ThotAlion/vanille_board_firmware/vanille_board_firmware/dog.jpg

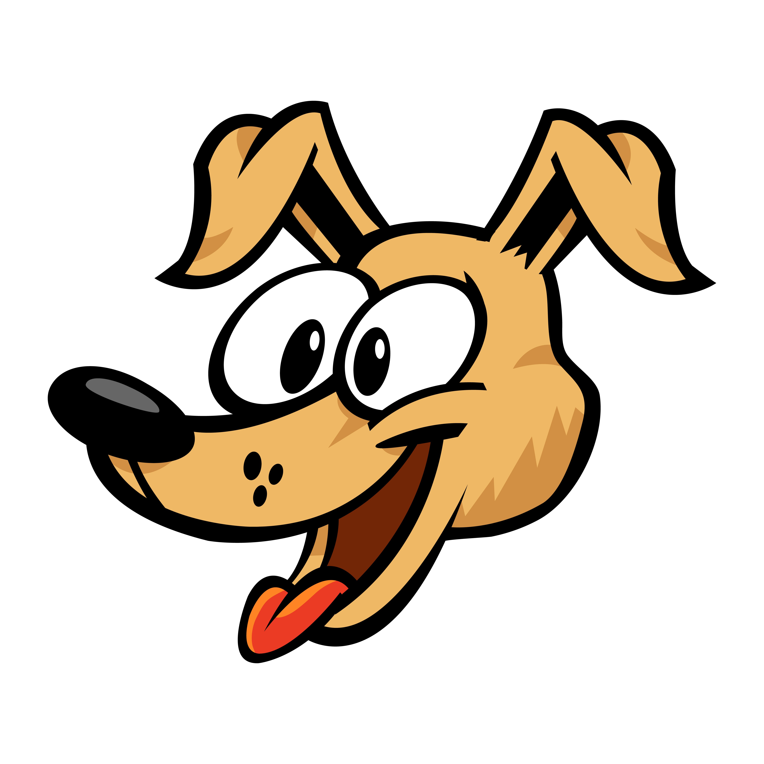
vanille_board_firmware/dog.jpg
