ThotAlion/vanille_board_firmware/vanille_board_firmware/dog.cpp

/***********************************************************************
************************************************************************
**                                                                    **
**       --------------Sparking Bitmap Converter--------------        **
**     Developed for I2C LCD, an easy-to-use display tool for makers. **
**                       Joney.S@foxmail.com                          **
**                                                                    **
************************************************************************
************************************************************************
*
* Code generated by
*
*        Sparking-BitmapConverter v1.0
*        Compiled May 15 2015
*        Sparking Work Speace
*
************************************************************************
*
* Source file: dog.jpg
* Dimensions:  56 * 48
*
************************************************************************
*/

#include "I2C_LCD.h"


#ifndef GUI_STORAGE_PTR
  #define GUI_STORAGE_PTR PROGMEM
#endif


const unsigned char GUI_STORAGE_PTR acdog[] = {
  ________, ________, ______X_, ________, ________, ________, ________,
  ________, ________, ___XXXXX, ________, ________, __XXX___, ________,
  ________, ______XX, XXXX___X, ________, ________, _X__XXXX, XX______,
  ________, _____XX_, _XX____X, ________, ________, _X___XXX, _XX_____,
  ________, _____X__, _X____X_, X_______, ________, XX____XX, __XX____,
  ________, ____XX__, X_______, X_______, ________, X_X____X, ___X____,
  ________, ____XX__, _____XX_, XX______, _______X, X_XX____, X__XX___,
  ________, ____XX__, _____XXX, _X______, _______X, __XX____, ___XX___,
  ________, ____XX__, ____XXXX, _XX_____, ______XX, _XXX____, ___XX___,
  ________, ____XX__, ___XXXXX, X_XX____, ______X_, XXXXX___, ___XX___,
  ________, ____XX__, ___XX_XX, XX_X____, _____X__, XXX_XX__, ___XX___,
  ________, ____X___, __X_XX_X, XXXXXXXX, XXXXXX_X, XXXXXX__, ___XX___,
  ________, ____X___, _XX__XX_, XXXX____, ______XX, XX_X__X_, ____X___,
  ________, ___XX___, XX____XX, XXX_____, ________, X_X____X, ____XX__,
  ________, __XX___X, X____XXX, XX______, ________, _XX____X, X____X__,
  ________, _XXXXXX_, __XX____, __XX_XXX, XXXX____, _XX_____, _XXXXXXX,
  ________, ________, _X______, ___XX___, ___X____, __X_____, ___XXX__,
  ________, ________, X_______, __X_____, ___XX___, __X_____, ________,
  ________, _______X, ________, __X_____, ____X___, __X_____, ________,
  ________, _______X, _____XX_, _X_X____, ____X___, __X_____, ________,
  ________, ______X_, ____XX__, X_XX____, ____X___, __X_____, ________,
  ________, ______X_, ____XXX_, X_X_X___, ___X____, __X_____, ________,
  ________, ______X_, ____XXX_, X_XXX___, ___X____, ___X____, ________,
  _XXXXXX_, _____XX_, ___XXX__, X_XX____, __X_____, ____X___, ________,
  XXXXXXXX, X_____X_, ____XXXX, X_XX____, XXXXX___, ____XX__, ________,
  XXXXXXXX, XX____XX, X___XXX_, XX___XXX, ________, _____X__, ________,
  XXXXXXXX, XXX____X, XXXXX___, _XXXX___, ________, _____X__, ________,
  _XXXXXXX, XXXXXXXX, XXX_____, ___X____, XXX_____, ____XX__, ________,
  __XXXXXX, XXXXX___, ________, _____XXX, XXX_____, ____XX__, ________,
  ___XXXXX, XXXX____, ________, ____XXXX, X_______, ____XX__, ________,
  ___XXXXX, XXX_____, XX______, _____XXX, X_______, ____X___, ________,
  ____XX_X, ________, XXXX____, ____XXXX, X_______, ___XX___, ________,
  _____XXX, X_______, ________, ___XXXXX, ________, ___X____, ________,
  _____XXX, X_______, _XX_____, __XXXXXX, ________, __X_____, ________,
  _______X, XX______, ________, XXXXXXXX, ________, XXX_____, ________,
  ________, XXXXX___, _____XXX, XXXXXXX_, _____XXX, X_______, ________,
  ________, ___XXXXX, XXXXXXXX, XXXXXXX_, _XXXXXX_, ________, ________,
  ________, ________, ______XX, XXXXXX__, X_______, ________, ________,
  ________, ________, _____X_X, XXXXX___, X_______, ________, ________,
  ________, ________, _____XXX, XXXXX__X, ________, ________, ________,
  ________, ________, __XXXXXX, XXXX__XX, ________, ________, ________,
  ________, ________, _XXXXX_X, XXX__XX_, ________, ________, ________,
  ________, ________, _XXXX_XX, XX__XX__, ________, ________, ________,
  ________, ________, X_XXXXXX, ___XX___, ________, ________, ________,
  ________, ________, XXXXXXXX, XXXX____, ________, ________, ________,
  ________, ________, XXXXXXXX, XXX_____, ________, ________, ________,
  ________, ________, XXXXX___, ________, ________, ________, ________,
  ________, ________, _X______, ________, ________, ________, ________

};

GUI_Bitmap_t bmdog = {
  56, /* XSize */
  48, /* YSize */
  7, /* BytesPerLine */
  1, /* BitsPerPixel */
  acdog,  /* Pointer to picture data (indices) */
};

/* *** End of file *** */
