ThotAlion/vanille_board_firmware/(commit log)

2021-05-02 Added solderable breadboard photo.
2021-09-17 version avec écran, molette, voltmetre et amperemetre
